MITEVT/opel_power_distribution_monitor/hardware/opel_pdm.kicad_pcb

## KiCad design hardware/opel_pdm.kicad_pcb (2016-10-30)

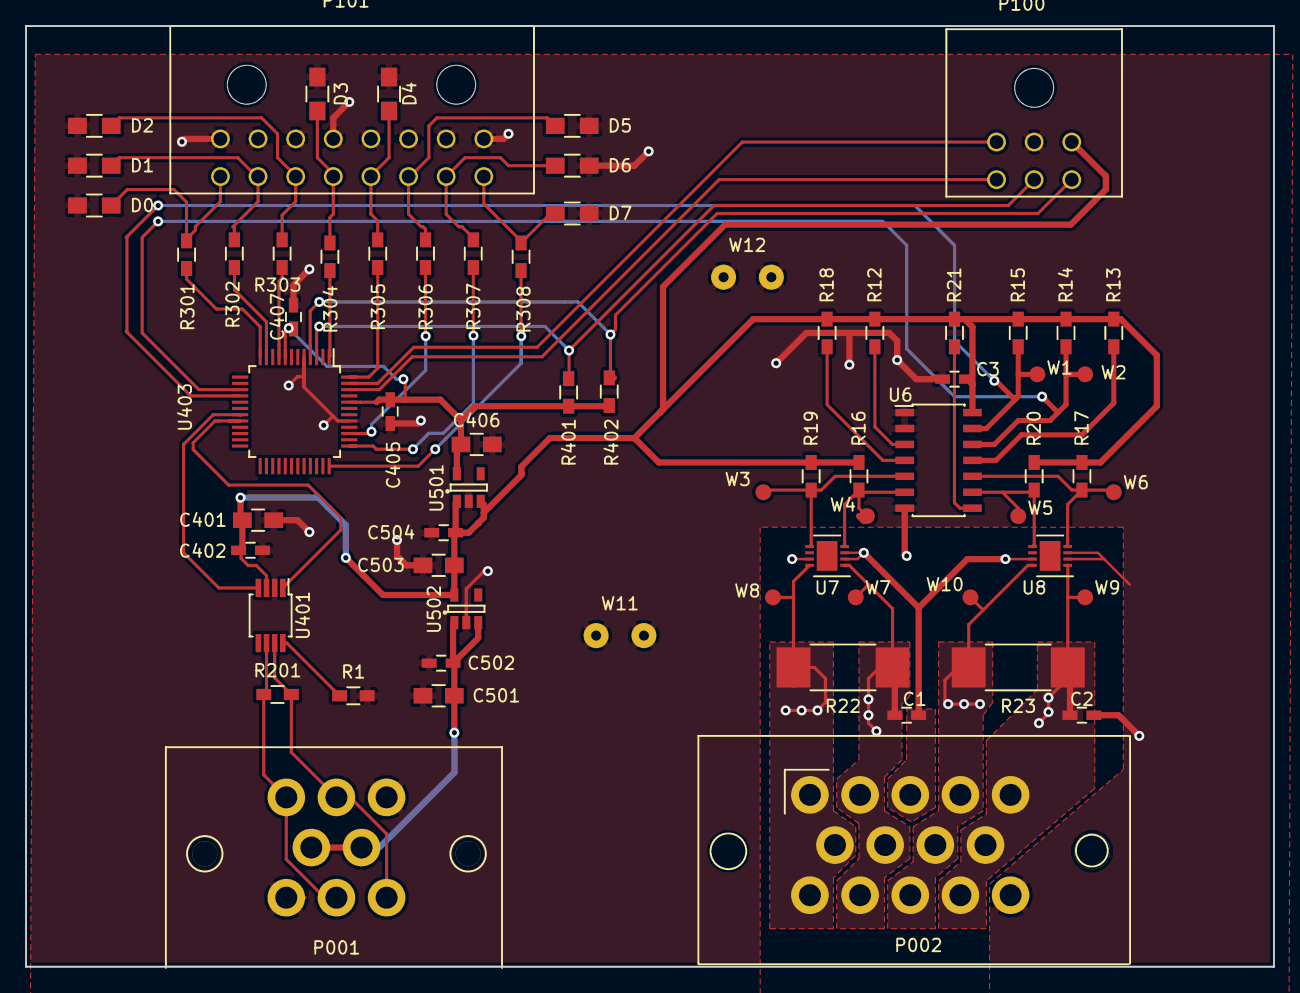
[picture p1: board opel_pdm.kicad_pcb from above]

Board: 2 copper layers, 99.5 x 75.0 mm, 67 parts (0 on the bottom side), 43 nets.

Parts:
C1, C2: 1uF; C_0603_HandSoldering
C3, C402, C405, C407: 0.1uF; C_0603_HandSoldering
C401, C406: 10uF; C_0805_HandSoldering
C501, C503: 10μ; C_0805_HandSoldering
C502, C504: .1μ; C_0603_HandSoldering
D0: PIO2_8; R_0805_HandSoldering
D1: PIO2_7; R_0805_HandSoldering
D2: PIO1_8; R_0805_HandSoldering
D3: PIO2_6; R_0805_HandSoldering
D4: PIO3_3; R_0805_HandSoldering
D5: PIO1_3; R_0805_HandSoldering
D6: PIO3_1; R_0805_HandSoldering
D7: PIO3_0; R_0805_HandSoldering
P001: CANCONNECTOR; 776280-1
P002: CONN_01X14; 776267-1
P100: ISP; Connector_Microfit3_Header_02x03_Angled_43045-060x
P101: DEBUG_LED; Connector_Microfit3_Header_02x08_Angled_43045-160x
R1: 20k; R_0603_HandSoldering
R12, R13, R14, R15, R16, R17, R18, R19, R20, R21, R401, R402: 10k; R_0603_HandSoldering
R22, R23: 0.002; R_2512_HandSoldering
R201: 120; R_0603_HandSoldering
R301, R302, R303, R304, R305, R306, R307, R308: 100; R_0603_HandSoldering
U6: TCA9543A; SOIC-14_3.9x8.7mm_Pitch1.27mm
U7, U8: LTC2943; DFN-8-1EP_3x3mm_Pitch0.5mm
U401: MCP2551-I/SN; MSOP-8_3x3mm_Pitch0.65mm
U403: LPC11C14; LQFP-48_7x7mm_Pitch0.5mm
U501: MCP1755-33; SOT-23-5
U502: MCP1755-5; SOT-23-5
W1: SDA; smd_test_pad
W2: SCL; smd_test_pad
W3: SD0; smd_test_pad
W4: SC0; smd_test_pad
W5, W6: SD1; smd_test_pad
W7: CS+; smd_test_pad
W8: CS-; smd_test_pad
W9: LV+; smd_test_pad
W10: LV-; smd_test_pad
W11, W12: TST_GND; SolderWirePad_2x_0-8mmDrill

Connections:
+3V3: C405.1, C406.1, C407.1, R401.1, R402.1, U403.8, U403.44, U501.5
+5V: C3.1, C401.1, C402.1, C503.1, C504.1, P100.3, R12.1, R13.1, R14.1, R15.1, R16.1, R17.1, R18.1, R19.1, R20.1, R21.1, U6.14, U401.3, U501.1, U501.3, U502.5
/BACK_PANEL/CANH: P001.2, P001.8, R201.2, U401.7
/BACK_PANEL/CANL: P001.1, P001.7, R201.1, U401.6
/BACK_PANEL/CS_SENSE+: C1.1, P002.2, P002.7, P002.11, R22.1, U7.1, W7.1
/BACK_PANEL/CS_SENSE-: P002.1, P002.6, P002.10, R22.2, U7.8, W8.1
/BACK_PANEL/LV_SENSE+: C2.1, P002.5, P002.9, P002.13, R23.1, U8.1, W9.1
/BACK_PANEL/LV_SENSE-: P002.4, P002.8, P002.12, R23.2, U8.8, W10.1
/FRONT_PANEL/LED0: R301.1, U403.12
/FRONT_PANEL/LED1: R302.2, U403.11
/FRONT_PANEL/LED2: R303.2, U403.9
/FRONT_PANEL/LED3: R304.1, U403.1
/FRONT_PANEL/LED4: R305.2, U403.48
/FRONT_PANEL/LED5: R306.1, U403.39
/FRONT_PANEL/LED6: R307.2, U403.37
/FRONT_PANEL/LED7: R308.1, U403.36
/FRONT_PANEL/MCU_PROG_N: P100.6, R402.2, U403.4
/FRONT_PANEL/MCU_RESET_N: P100.5, R401.2, U403.3
/FRONT_PANEL/RXD: P100.4, U403.46
/FRONT_PANEL/TXD: P100.1, U403.47
/I2C Multiplexer and Gas Gauges/SCL: R14.2, U6.12, U403.15, W2.1
/I2C Multiplexer and Gas Gauges/SDA: R15.2, U6.13, U403.16, W1.1
/Micro_Controller/CAN_RXD: U401.4, U403.19
/Micro_Controller/CAN_TXD: U401.1, U403.20
/Power_Supplies/+12V: C501.2, C502.1, P001.4, P001.5, U502.1, U502.3
GND: C1.2, C2.2, C3.2, C401.2, C402.2, C405.2, C406.2, C407.2, C501.1, C502.2, C503.2, C504.2, D0.1, D1.1, D2.1, D3.1, D4.1, D5.1, D6.1, D7.1, P001.3, P001.6, P002.3, P002.14, P100.2, P101.1, P101.2, P101.3, P101.4, P101.5, P101.6, P101.7, P101.8, R1.2, U6.1, U6.2, U6.7, U7.2, U7.3, U7.7, U8.2, U8.3, U8.7, U401.2, U403.5, U403.41, U501.2, U502.2, W11.1, W12.1
unnamed: D0.2, P101.9, R301.2
unnamed: D1.2, P101.10, R302.1
unnamed: D2.2, P101.11, R303.1
unnamed: D3.2, P101.12, R304.2
unnamed: D4.2, P101.13, R305.1
unnamed: D5.2, P101.14, R306.2
unnamed: D6.2, P101.15, R307.1
unnamed: D7.2, P101.16, R308.2
unnamed: R1.1, U401.8
unnamed: R12.2, U6.3
unnamed: R13.2, U6.11
unnamed: R16.2, U6.6, U7.4, W4.1
unnamed: R17.2, U6.10, U8.4, W6.1
unnamed: R18.2, U6.4
unnamed: R19.2, U6.5, U7.5, W3.1
unnamed: R20.2, U6.9, U8.5, W5.1
unnamed: R21.2, U6.8
