MITEVT/opel_power_distribution_monitor/firmware/inc/can_spec_constants.h

#define BMS_HEARTBEAT__id 1536
#define BMS_HEARTBEAT__freq 1
#define __BMS_HEARTBEAT__DEVICE_ID__start 0
#define __BMS_HEARTBEAT__DEVICE_ID__end 31
#define ____BMS_HEARTBEAT__DEVICE_ID__DEVICE_ID__FROM 0
#define ____BMS_HEARTBEAT__DEVICE_ID__DEVICE_ID__TO 4294967295
#define __BMS_HEARTBEAT__SERIAL_NO__start 32
#define __BMS_HEARTBEAT__SERIAL_NO__end 63
#define ____BMS_HEARTBEAT__SERIAL_NO__SERIAL_NO__FROM 0
#define ____BMS_HEARTBEAT__SERIAL_NO__SERIAL_NO__TO 4294967295

#define TI_PACKET__id 769
#define TI_PACKET__freq 100
#define __TI_PACKET__ACC_VAL__start 0
#define __TI_PACKET__ACC_VAL__end 7
#define ____TI_PACKET__ACC_VAL__ACC_VAL__FROM 0
#define ____TI_PACKET__ACC_VAL__ACC_VAL__TO 255
#define __TI_PACKET__BRAKE_VAL__start 8
#define __TI_PACKET__BRAKE_VAL__end 15
#define ____TI_PACKET__BRAKE_VAL__BRAKE_VAL__FROM 0
#define ____TI_PACKET__BRAKE_VAL__BRAKE_VAL__TO 255
#define __TI_PACKET__FLAGS__start 16
#define __TI_PACKET__FLAGS__end 23
#define ____TI_PACKET__FLAGS__FLAGS__FROM 0
#define ____TI_PACKET__FLAGS__FLAGS__TO 255

#define WHEEL_VELOCITY_1__id 1795
#define WHEEL_VELOCITY_1__freq 5
#define __WHEEL_VELOCITY_1__WHEEL_VELOCITY_1__start 0
#define __WHEEL_VELOCITY_1__WHEEL_VELOCITY_1__end 15
#define ____WHEEL_VELOCITY_1__WHEEL_VELOCITY_1__WHEEL_VELOCITY_RPM__FROM 0
#define ____WHEEL_VELOCITY_1__WHEEL_VELOCITY_1__WHEEL_VELOCITY_RPM__TO 65535

#define WHEEL_VELOCITY_2__id 1796
#define WHEEL_VELOCITY_2__freq 5
#define __WHEEL_VELOCITY_2__WHEEL_VELOCITY_2__start 0
#define __WHEEL_VELOCITY_2__WHEEL_VELOCITY_2__end 15
#define ____WHEEL_VELOCITY_2__WHEEL_VELOCITY_2__WHEEL_VELOCITY_RPM__FROM 0
#define ____WHEEL_VELOCITY_2__WHEEL_VELOCITY_2__WHEEL_VELOCITY_RPM__TO 65535

#define MI_PACKET__id 1797
#define MI_PACKET__freq 1
#define __MI_PACKET__IS_SHUTDOWN_OK__start 0
#define __MI_PACKET__IS_SHUTDOWN_OK__end 1
#define ____MI_PACKET__IS_SHUTDOWN_OK__OK 0
#define ____MI_PACKET__IS_SHUTDOWN_OK__NOT_OKAY 1
#define __MI_PACKET__MOTOR_CURRENT__start 2
#define __MI_PACKET__MOTOR_CURRENT__end 17
#define ____MI_PACKET__MOTOR_CURRENT__CURRENT_AMPS__FROM 0
#define ____MI_PACKET__MOTOR_CURRENT__CURRENT_AMPS__TO 65535

#define ERROR_PACKET__id 1286
#define ERROR_PACKET__freq 2
#define __ERROR_PACKET__ERROR__start 0
#define __ERROR_PACKET__ERROR__end 19
#define ____ERROR_PACKET__ERROR__LOST_VELOCITY_HEARTBEAT 0
#define ____ERROR_PACKET__ERROR__LOST_PDM_YHEARTBEAT 240
#define ____ERROR_PACKET__ERROR__LOST_BMS_HEARTBEAT 61440
#define ____ERROR_PACKET__ERROR__LOST_THROTTLE_HEARTBEAT 3840
#define ____ERROR_PACKET__ERROR__ERROR_NONE 983040

#define BRUSA_NLG5_DIAG_RX__id 1816
#define BRUSA_NLG5_DIAG_RX__freq -1

#define BRUSA_NLG5_STATUS__id 1552
#define BRUSA_NLG5_STATUS__freq 10

#define BRUSA_NLG5_ACTUAL_VALUES_1__id 1553
#define BRUSA_NLG5_ACTUAL_VALUES_1__freq 10

#define BRUSA_NLG5_ACTUAL_VALUES_2__id 1554
#define BRUSA_NLG5_ACTUAL_VALUES_2__freq 10

#define BRUSA_NLG5_TEMP_FEEDBACK__id 1555
#define BRUSA_NLG5_TEMP_FEEDBACK__freq 1

#define BRUSA_NLG5_ERRORS__id 1556
#define BRUSA_NLG5_ERRORS__freq 1

#define BRUSA_NLG5_CONTROL__id 1560
#define BRUSA_NLG5_CONTROL__freq 10

#define BRUSA_NLG5_DIAG_TX__id 1818
#define BRUSA_NLG5_DIAG_TX__freq -1

#define PDM_PACKET__id 773
#define PDM_PACKET__freq 10
#define __PDM_PACKET__LOW_VOLTAGE_BUS_BATTERY_FLAG__start 0
#define __PDM_PACKET__LOW_VOLTAGE_BUS_BATTERY_FLAG__end 0
#define ____PDM_PACKET__LOW_VOLTAGE_BUS_BATTERY_FLAG__DOWN 0
#define ____PDM_PACKET__LOW_VOLTAGE_BUS_BATTERY_FLAG__UP 1
#define __PDM_PACKET__LOW_VOLTAGE_DC_DC_STATUS__start 1
#define __PDM_PACKET__LOW_VOLTAGE_DC_DC_STATUS__end 1
#define ____PDM_PACKET__LOW_VOLTAGE_DC_DC_STATUS__OFF 0
#define ____PDM_PACKET__LOW_VOLTAGE_DC_DC_STATUS__ON 1
#define __PDM_PACKET__CRITICAL_SYSTEMS_BATTERY_FLAG__start 2
#define __PDM_PACKET__CRITICAL_SYSTEMS_BATTERY_FLAG__end 2
#define ____PDM_PACKET__CRITICAL_SYSTEMS_BATTERY_FLAG__DOWN 0
#define ____PDM_PACKET__CRITICAL_SYSTEMS_BATTERY_FLAG__UP 1
#define __PDM_PACKET__CRITICAL_SYSTEMS_DC_DC_STATUS__start 3
#define __PDM_PACKET__CRITICAL_SYSTEMS_DC_DC_STATUS__end 3
#define ____PDM_PACKET__CRITICAL_SYSTEMS_DC_DC_STATUS__OFF 0
#define ____PDM_PACKET__CRITICAL_SYSTEMS_DC_DC_STATUS__ON 1
#define __PDM_PACKET__PDM_STATUS__start 4
#define __PDM_PACKET__PDM_STATUS__end 4
#define ____PDM_PACKET__PDM_STATUS__OFF 0
#define ____PDM_PACKET__PDM_STATUS__ON 1

#define TRITIUM_BOOTLOADER_RESERVED4__id 2036
#define TRITIUM_BOOTLOADER_RESERVED4__freq -1

#define UI_PACKET__id 2037
#define UI_PACKET__freq 1
#define __UI_PACKET__UI_HEARTBEAT__start 0
#define __UI_PACKET__UI_HEARTBEAT__end 0
#define ____UI_PACKET__UI_HEARTBEAT__RUNNING 1

#define DI_PACKET__id 1285
#define DI_PACKET__freq 10
#define __DI_PACKET__KEY_IGNITION__start 0
#define __DI_PACKET__KEY_IGNITION__end 15
#define ____DI_PACKET__KEY_IGNITION__RUN 32
#define ____DI_PACKET__KEY_IGNITION__START 64
#define __DI_PACKET__DRIVE_STATUS__start 16
#define __DI_PACKET__DRIVE_STATUS__end 31
#define ____DI_PACKET__DRIVE_STATUS__PARKED 0
#define ____DI_PACKET__DRIVE_STATUS__CHARGE 61440
#define ____DI_PACKET__DRIVE_STATUS__OFF 12288
#define ____DI_PACKET__DRIVE_STATUS__REVERSE 48
#define ____DI_PACKET__DRIVE_STATUS__FORWARD 240
#define ____DI_PACKET__DRIVE_STATUS__SHUTDOWN_IMPENDING 3840
#define ____DI_PACKET__DRIVE_STATUS__INIT 768

#define TRITIUM_BOOTLOADER_RESERVED0__id 2032
#define TRITIUM_BOOTLOADER_RESERVED0__freq -1

#define TRITIUM_BOOTLOADER_RESERVED1__id 2033
#define TRITIUM_BOOTLOADER_RESERVED1__freq -1

#define TRITIUM_BOOTLOADER_RESERVED2__id 2034
#define TRITIUM_BOOTLOADER_RESERVED2__freq -1

#define TRITIUM_BOOTLOADER_RESERVED3__id 2035
#define TRITIUM_BOOTLOADER_RESERVED3__freq -1

#define PACK_CHARGE__id 1780
#define PACK_CHARGE__freq 1
#define __PACK_CHARGE__CHARGE_AH__start 0
#define __PACK_CHARGE__CHARGE_AH__end 31
#define ____PACK_CHARGE__CHARGE_AH__CHARGE_Ah 0
#define __PACK_CHARGE__CHARGE_PERCENTAGE__start 32
#define __PACK_CHARGE__CHARGE_PERCENTAGE__end 63
#define ____PACK_CHARGE__CHARGE_PERCENTAGE__CHARGE_PERCENTAGE 0

#define PACK_CHARGE_MISBALANCE__id 1781
#define PACK_CHARGE_MISBALANCE__freq 1
#define __PACK_CHARGE_MISBALANCE__BALANCE_SOC__start 0
#define __PACK_CHARGE_MISBALANCE__BALANCE_SOC__end 31
#define ____PACK_CHARGE_MISBALANCE__BALANCE_SOC__MISMATCH_CORRECTED_BALANCE_MISMATCH_Ah 0
#define __PACK_CHARGE_MISBALANCE__PACK_BALANCE_SOC__start 32
#define __PACK_CHARGE_MISBALANCE__PACK_BALANCE_SOC__end 63
#define ____PACK_CHARGE_MISBALANCE__PACK_BALANCE_SOC__CHARGE_PERCENTAGE_MISMATCH 0

#define CHARGING_CONTROL_INFO__id 1782
#define CHARGING_CONTROL_INFO__freq 10
#define __CHARGING_CONTROL_INFO__CHARGING_CELL_VOLTAGE_ERROR__start 0
#define __CHARGING_CONTROL_INFO__CHARGING_CELL_VOLTAGE_ERROR__end 15
#define ____CHARGING_CONTROL_INFO__CHARGING_CELL_VOLTAGE_ERROR__ERROR_mV__FROM 0
#define ____CHARGING_CONTROL_INFO__CHARGING_CELL_VOLTAGE_ERROR__ERROR_mV__TO 65535
#define __CHARGING_CONTROL_INFO__CELL_TEMP_MARGIN__start 16
#define __CHARGING_CONTROL_INFO__CELL_TEMP_MARGIN__end 31
#define ____CHARGING_CONTROL_INFO__CELL_TEMP_MARGIN__CELL_TEMP_TENTH_C__FROM 0
#define ____CHARGING_CONTROL_INFO__CELL_TEMP_MARGIN__CELL_TEMP_TENTH_C__TO 65535
#define __CHARGING_CONTROL_INFO__DISCHARGING_CELL_VOLTAGE_ERROR__start 32
#define __CHARGING_CONTROL_INFO__DISCHARGING_CELL_VOLTAGE_ERROR__end 47
#define ____CHARGING_CONTROL_INFO__DISCHARGING_CELL_VOLTAGE_ERROR__ERROR_mV__FROM 0
#define ____CHARGING_CONTROL_INFO__DISCHARGING_CELL_VOLTAGE_ERROR__ERROR_mV__TO 65535
#define __CHARGING_CONTROL_INFO__TOTAL_PACK_CAPACITY__start 48
#define __CHARGING_CONTROL_INFO__TOTAL_PACK_CAPACITY__end 63
#define ____CHARGING_CONTROL_INFO__TOTAL_PACK_CAPACITY__CAPACITY_Ah__FROM 0
#define ____CHARGING_CONTROL_INFO__TOTAL_PACK_CAPACITY__CAPACITY_Ah__TO 65535

#define PRECHARGE_STATUS__id 1783
#define PRECHARGE_STATUS__freq 1
#define __PRECHARGE_STATUS__CONTACTOR_1_ERROR__start 0
#define __PRECHARGE_STATUS__CONTACTOR_1_ERROR__end 0
#define ____PRECHARGE_STATUS__CONTACTOR_1_ERROR__OK 0
#define ____PRECHARGE_STATUS__CONTACTOR_1_ERROR__FAULT 1
#define __PRECHARGE_STATUS__CONTACTOR_2_ERROR__start 1
#define __PRECHARGE_STATUS__CONTACTOR_2_ERROR__end 1
#define ____PRECHARGE_STATUS__CONTACTOR_2_ERROR__OK 0
#define ____PRECHARGE_STATUS__CONTACTOR_2_ERROR__FAULT 1
#define __PRECHARGE_STATUS__CONTACTOR_1_STATUS__start 2
#define __PRECHARGE_STATUS__CONTACTOR_1_STATUS__end 2
#define ____PRECHARGE_STATUS__CONTACTOR_1_STATUS__OFF 0
#define ____PRECHARGE_STATUS__CONTACTOR_1_STATUS__ON 1
#define __PRECHARGE_STATUS__CONTACTOR_2_STATUS__start 3
#define __PRECHARGE_STATUS__CONTACTOR_2_STATUS__end 3
#define ____PRECHARGE_STATUS__CONTACTOR_2_STATUS__OFF 0
#define ____PRECHARGE_STATUS__CONTACTOR_2_STATUS__ON 1
#define __PRECHARGE_STATUS__12V_CONTACTOR_STATUS__start 4
#define __PRECHARGE_STATUS__12V_CONTACTOR_STATUS__end 4
#define ____PRECHARGE_STATUS__12V_CONTACTOR_STATUS__FAULT 0
#define ____PRECHARGE_STATUS__12V_CONTACTOR_STATUS__OK 1
#define __PRECHARGE_STATUS__CONTACTOR_3_ERROR__start 5
#define __PRECHARGE_STATUS__CONTACTOR_3_ERROR__end 5
#define ____PRECHARGE_STATUS__CONTACTOR_3_ERROR__OK 0
#define ____PRECHARGE_STATUS__CONTACTOR_3_ERROR__FAULT 1
#define __PRECHARGE_STATUS__CONTACTOR_3_STATUS__start 6
#define __PRECHARGE_STATUS__CONTACTOR_3_STATUS__end 6
#define ____PRECHARGE_STATUS__CONTACTOR_3_STATUS__OFF 0
#define ____PRECHARGE_STATUS__CONTACTOR_3_STATUS__ON 1
#define __PRECHARGE_STATUS__PRECHARGE_STATE__start 7
#define __PRECHARGE_STATUS__PRECHARGE_STATE__end 7

#define CELL_VOLTAGES__id 1784
#define CELL_VOLTAGES__freq 10
#define __CELL_VOLTAGES__MIN_CELL_VOLTAGE__start 0
#define __CELL_VOLTAGES__MIN_CELL_VOLTAGE__end 15
#define ____CELL_VOLTAGES__MIN_CELL_VOLTAGE__VOLTAGE_mV__FROM 0
#define ____CELL_VOLTAGES__MIN_CELL_VOLTAGE__VOLTAGE_mV__TO 65535
#define __CELL_VOLTAGES__MAX_CELL_VOLTAGE__start 16
#define __CELL_VOLTAGES__MAX_CELL_VOLTAGE__end 31
#define ____CELL_VOLTAGES__MAX_CELL_VOLTAGE__VOLTAGE_mV__FROM 0
#define ____CELL_VOLTAGES__MAX_CELL_VOLTAGE__VOLTAGE_mV__TO 65535
#define __CELL_VOLTAGES__CMU_WITH_MIN_VOLTAGE__start 32
#define __CELL_VOLTAGES__CMU_WITH_MIN_VOLTAGE__end 39
#define ____CELL_VOLTAGES__CMU_WITH_MIN_VOLTAGE__CMU_NO__FROM 0
#define ____CELL_VOLTAGES__CMU_WITH_MIN_VOLTAGE__CMU_NO__TO 255
#define __CELL_VOLTAGES__CELL_WITH_MIN_VOLTAGE__start 40
#define __CELL_VOLTAGES__CELL_WITH_MIN_VOLTAGE__end 47
#define ____CELL_VOLTAGES__CELL_WITH_MIN_VOLTAGE__CELL_NO__FROM 0
#define ____CELL_VOLTAGES__CELL_WITH_MIN_VOLTAGE__CELL_NO__TO 255
#define __CELL_VOLTAGES__CMU_WITH_MAX_VOLTAGE__start 48
#define __CELL_VOLTAGES__CMU_WITH_MAX_VOLTAGE__end 55
#define ____CELL_VOLTAGES__CMU_WITH_MAX_VOLTAGE__CMU_NO__FROM 0
#define ____CELL_VOLTAGES__CMU_WITH_MAX_VOLTAGE__CMU_NO__TO 255
#define __CELL_VOLTAGES__CELL_WITH_MAX_VOLTAGE__start 56
#define __CELL_VOLTAGES__CELL_WITH_MAX_VOLTAGE__end 63
#define ____CELL_VOLTAGES__CELL_WITH_MAX_VOLTAGE__CELL_NO__FROM 0
#define ____CELL_VOLTAGES__CELL_WITH_MAX_VOLTAGE__CELL_NO__TO 255

#define CELL_TEMPS__id 1785
#define CELL_TEMPS__freq 1
#define __CELL_TEMPS__MIN_CELL_TEMP__start 0
#define __CELL_TEMPS__MIN_CELL_TEMP__end 15
#define ____CELL_TEMPS__MIN_CELL_TEMP__TEMP_TENTHS_C__FROM 0
#define ____CELL_TEMPS__MIN_CELL_TEMP__TEMP_TENTHS_C__TO 65535
#define __CELL_TEMPS__MAX_CELL_TEMP__start 16
#define __CELL_TEMPS__MAX_CELL_TEMP__end 31
#define ____CELL_TEMPS__MAX_CELL_TEMP__TEMP_TENTHS_C__FROM 0
#define ____CELL_TEMPS__MAX_CELL_TEMP__TEMP_TENTHS_C__TO 65535
#define __CELL_TEMPS__CMU_WITH_MIN_TEMP__start 32
#define __CELL_TEMPS__CMU_WITH_MIN_TEMP__end 39
#define ____CELL_TEMPS__CMU_WITH_MIN_TEMP__CMU_NO__FROM 0
#define ____CELL_TEMPS__CMU_WITH_MIN_TEMP__CMU_NO__TO 255
#define __CELL_TEMPS__CMU_WITH_MAX_TEMP__start 48
#define __CELL_TEMPS__CMU_WITH_MAX_TEMP__end 55
#define ____CELL_TEMPS__CMU_WITH_MAX_TEMP__CMU_NO__FROM 0
#define ____CELL_TEMPS__CMU_WITH_MAX_TEMP__CMU_NO__TO 255

#define BATTERY_CURRENT_VOLTAGE__id 1786
#define BATTERY_CURRENT_VOLTAGE__freq 10
#define __BATTERY_CURRENT_VOLTAGE__VOLTAGE__start 0
#define __BATTERY_CURRENT_VOLTAGE__VOLTAGE__end 31
#define ____BATTERY_CURRENT_VOLTAGE__VOLTAGE__VOLTAGE_mV__FROM 0
#define ____BATTERY_CURRENT_VOLTAGE__VOLTAGE__VOLTAGE_mV__TO 4294967295
#define __BATTERY_CURRENT_VOLTAGE__CURRENT__start 32
#define __BATTERY_CURRENT_VOLTAGE__CURRENT__end 63
#define ____BATTERY_CURRENT_VOLTAGE__CURRENT__CURRENT_mA__FROM 0
#define ____BATTERY_CURRENT_VOLTAGE__CURRENT__CURRENT_mA__TO 4294967295

#define OVERALL_PACK_STATUS__id 1787
#define OVERALL_PACK_STATUS__freq 0
#define __OVERALL_PACK_STATUS__BALANCE_VOLTAGE_THRESHOLD_RISING__start 0
#define __OVERALL_PACK_STATUS__BALANCE_VOLTAGE_THRESHOLD_RISING__end 15
#define ____OVERALL_PACK_STATUS__BALANCE_VOLTAGE_THRESHOLD_RISING__THRESHOLD__FROM 0
#define ____OVERALL_PACK_STATUS__BALANCE_VOLTAGE_THRESHOLD_RISING__THRESHOLD__TO 65535
#define __OVERALL_PACK_STATUS__BALANCE_VOLTAGE_THRESHOLD_FALLING__start 16
#define __OVERALL_PACK_STATUS__BALANCE_VOLTAGE_THRESHOLD_FALLING__end 31
#define ____OVERALL_PACK_STATUS__BALANCE_VOLTAGE_THRESHOLD_FALLING__THRESHOLD__FROM 0
#define ____OVERALL_PACK_STATUS__BALANCE_VOLTAGE_THRESHOLD_FALLING__THRESHOLD__TO 65535
#define __OVERALL_PACK_STATUS__CELL_OVER_VOLTAGE__start 32
#define __OVERALL_PACK_STATUS__CELL_OVER_VOLTAGE__end 32
#define ____OVERALL_PACK_STATUS__CELL_OVER_VOLTAGE__FALSE 0
#define ____OVERALL_PACK_STATUS__CELL_OVER_VOLTAGE__TRUE 1
#define __OVERALL_PACK_STATUS__CELL_UNDER_VOLTAGE__start 33
#define __OVERALL_PACK_STATUS__CELL_UNDER_VOLTAGE__end 33
#define ____OVERALL_PACK_STATUS__CELL_UNDER_VOLTAGE__FALSE 0
#define ____OVERALL_PACK_STATUS__CELL_UNDER_VOLTAGE__TRUE 1
#define __OVERALL_PACK_STATUS__CELL_OVER_TEMPERATURE__start 34
#define __OVERALL_PACK_STATUS__CELL_OVER_TEMPERATURE__end 34
#define ____OVERALL_PACK_STATUS__CELL_OVER_TEMPERATURE__FALSE 0
#define ____OVERALL_PACK_STATUS__CELL_OVER_TEMPERATURE__TRUE 1
#define __OVERALL_PACK_STATUS__MEASUREMENTS_UNTRUSTED__start 35
#define __OVERALL_PACK_STATUS__MEASUREMENTS_UNTRUSTED__end 35
#define ____OVERALL_PACK_STATUS__MEASUREMENTS_UNTRUSTED__FALSE 0
#define ____OVERALL_PACK_STATUS__MEASUREMENTS_UNTRUSTED__TRUE 1
#define __OVERALL_PACK_STATUS__CMU_COMMUNICATION_TIMEOUT__start 36
#define __OVERALL_PACK_STATUS__CMU_COMMUNICATION_TIMEOUT__end 36
#define ____OVERALL_PACK_STATUS__CMU_COMMUNICATION_TIMEOUT__FALSE 0
#define ____OVERALL_PACK_STATUS__CMU_COMMUNICATION_TIMEOUT__TRUE 1
#define __OVERALL_PACK_STATUS__VEHICLE_COMMUNICATIONS_TIMOUT__start 37
#define __OVERALL_PACK_STATUS__VEHICLE_COMMUNICATIONS_TIMOUT__end 37
#define ____OVERALL_PACK_STATUS__VEHICLE_COMMUNICATIONS_TIMOUT__FALSE 0
#define ____OVERALL_PACK_STATUS__VEHICLE_COMMUNICATIONS_TIMOUT__TRUE 1
#define __OVERALL_PACK_STATUS__BMS_SETUP_MODE__start 38
#define __OVERALL_PACK_STATUS__BMS_SETUP_MODE__end 38
#define ____OVERALL_PACK_STATUS__BMS_SETUP_MODE__OFF 0
#define ____OVERALL_PACK_STATUS__BMS_SETUP_MODE__ON 1
#define __OVERALL_PACK_STATUS__CMU_CAN_POWER_STATUS__start 39
#define __OVERALL_PACK_STATUS__CMU_CAN_POWER_STATUS__end 39
#define ____OVERALL_PACK_STATUS__CMU_CAN_POWER_STATUS__OFF 0
#define ____OVERALL_PACK_STATUS__CMU_CAN_POWER_STATUS__ON 1
#define __OVERALL_PACK_STATUS__CMU_COUNT__start 40
#define __OVERALL_PACK_STATUS__CMU_COUNT__end 47
#define ____OVERALL_PACK_STATUS__CMU_COUNT__COUNT__FROM 0
#define ____OVERALL_PACK_STATUS__CMU_COUNT__COUNT__TO 255
#define __OVERALL_PACK_STATUS__FIRMWARE_BUILD_NO__start 48
#define __OVERALL_PACK_STATUS__FIRMWARE_BUILD_NO__end 63
#define ____OVERALL_PACK_STATUS__FIRMWARE_BUILD_NO__VERSION__FROM 0
#define ____OVERALL_PACK_STATUS__FIRMWARE_BUILD_NO__VERSION__TO 65535

#define FAN_INFO__id 1788
#define FAN_INFO__freq 0
#define __FAN_INFO__FAN0_STATUS__start 0
#define __FAN_INFO__FAN0_STATUS__end 15
#define ____FAN_INFO__FAN0_STATUS__SPEED_RPM__FROM 0
#define ____FAN_INFO__FAN0_STATUS__SPEED_RPM__TO 65535
#define __FAN_INFO__FAN1_STATUS__start 16
#define __FAN_INFO__FAN1_STATUS__end 31
#define ____FAN_INFO__FAN1_STATUS__SPEED_RPM__FROM 0
#define ____FAN_INFO__FAN1_STATUS__SPEED_RPM__TO 65535
#define __FAN_INFO__FAN_AND_CONTACTOR_12V_CURRENT_CONSUMPTION__start 32
#define __FAN_INFO__FAN_AND_CONTACTOR_12V_CURRENT_CONSUMPTION__end 47
#define ____FAN_INFO__FAN_AND_CONTACTOR_12V_CURRENT_CONSUMPTION__CONSUMPTION_mA__FROM 0
#define ____FAN_INFO__FAN_AND_CONTACTOR_12V_CURRENT_CONSUMPTION__CONSUMPTION_mA__TO 65535
#define __FAN_INFO__CMU_12V_CURRENT_CONSUMPTION__start 48
#define __FAN_INFO__CMU_12V_CURRENT_CONSUMPTION__end 63
#define ____FAN_INFO__CMU_12V_CURRENT_CONSUMPTION__CONSUMPTION_mA__FROM 0
#define ____FAN_INFO__CMU_12V_CURRENT_CONSUMPTION__CONSUMPTION_mA__TO 65535

#define EXTENDED_PACK_STATUS__id 1789
#define EXTENDED_PACK_STATUS__freq 0
#define __EXTENDED_PACK_STATUS__CELL_OVER_VOLTAGE__start 0
#define __EXTENDED_PACK_STATUS__CELL_OVER_VOLTAGE__end 0
#define ____EXTENDED_PACK_STATUS__CELL_OVER_VOLTAGE__FALSE 0
#define ____EXTENDED_PACK_STATUS__CELL_OVER_VOLTAGE__TRUE 1
#define __EXTENDED_PACK_STATUS__CELL_UNDER_VOLTAGE__start 1
#define __EXTENDED_PACK_STATUS__CELL_UNDER_VOLTAGE__end 1
#define ____EXTENDED_PACK_STATUS__CELL_UNDER_VOLTAGE__FALSE 0
#define ____EXTENDED_PACK_STATUS__CELL_UNDER_VOLTAGE__TRUE 1
#define __EXTENDED_PACK_STATUS__CELL_OVER_TEMPERATURE__start 2
#define __EXTENDED_PACK_STATUS__CELL_OVER_TEMPERATURE__end 2
#define ____EXTENDED_PACK_STATUS__CELL_OVER_TEMPERATURE__FALSE 0
#define ____EXTENDED_PACK_STATUS__CELL_OVER_TEMPERATURE__TRUE 1
#define __EXTENDED_PACK_STATUS__MEASUREMENTS_UNTRUSTED__start 3
#define __EXTENDED_PACK_STATUS__MEASUREMENTS_UNTRUSTED__end 3
#define ____EXTENDED_PACK_STATUS__MEASUREMENTS_UNTRUSTED__FALSE 0
#define ____EXTENDED_PACK_STATUS__MEASUREMENTS_UNTRUSTED__TRUE 1
#define __EXTENDED_PACK_STATUS__LOST_CMU_COMMUNICATION__start 4
#define __EXTENDED_PACK_STATUS__LOST_CMU_COMMUNICATION__end 4
#define ____EXTENDED_PACK_STATUS__LOST_CMU_COMMUNICATION__FALSE 0
#define ____EXTENDED_PACK_STATUS__LOST_CMU_COMMUNICATION__TRUE 1
#define __EXTENDED_PACK_STATUS__VEHICLE_COMMUNICATIONS_TIMOUT__start 5
#define __EXTENDED_PACK_STATUS__VEHICLE_COMMUNICATIONS_TIMOUT__end 5
#define ____EXTENDED_PACK_STATUS__VEHICLE_COMMUNICATIONS_TIMOUT__FALSE 0
#define ____EXTENDED_PACK_STATUS__VEHICLE_COMMUNICATIONS_TIMOUT__TRUE 1
#define __EXTENDED_PACK_STATUS__BMS_SETUP_MODE__start 6
#define __EXTENDED_PACK_STATUS__BMS_SETUP_MODE__end 6
#define ____EXTENDED_PACK_STATUS__BMS_SETUP_MODE__OFF 0
#define ____EXTENDED_PACK_STATUS__BMS_SETUP_MODE__ON 1
#define __EXTENDED_PACK_STATUS__CMU_CAN_POWER_STATUS__start 7
#define __EXTENDED_PACK_STATUS__CMU_CAN_POWER_STATUS__end 7
#define ____EXTENDED_PACK_STATUS__CMU_CAN_POWER_STATUS__OFF 0
#define ____EXTENDED_PACK_STATUS__CMU_CAN_POWER_STATUS__ON 1
#define __EXTENDED_PACK_STATUS__PACK_ISOLATION_TEST_FAILURE__start 8
#define __EXTENDED_PACK_STATUS__PACK_ISOLATION_TEST_FAILURE__end 8
#define ____EXTENDED_PACK_STATUS__PACK_ISOLATION_TEST_FAILURE__FALSE 0
#define ____EXTENDED_PACK_STATUS__PACK_ISOLATION_TEST_FAILURE__TRUE 1
#define __EXTENDED_PACK_STATUS__INVALID_SOC_MEASUREMENT__start 9
#define __EXTENDED_PACK_STATUS__INVALID_SOC_MEASUREMENT__end 9
#define ____EXTENDED_PACK_STATUS__INVALID_SOC_MEASUREMENT__FALSE 0
#define ____EXTENDED_PACK_STATUS__INVALID_SOC_MEASUREMENT__TRUE 1
#define __EXTENDED_PACK_STATUS__CAN_12V_SUPPLY_LOW__start 10
#define __EXTENDED_PACK_STATUS__CAN_12V_SUPPLY_LOW__end 10
#define ____EXTENDED_PACK_STATUS__CAN_12V_SUPPLY_LOW__FALSE 0
#define ____EXTENDED_PACK_STATUS__CAN_12V_SUPPLY_LOW__TRUE 1
#define __EXTENDED_PACK_STATUS__CONTACTOR_STUCK__start 11
#define __EXTENDED_PACK_STATUS__CONTACTOR_STUCK__end 11
#define ____EXTENDED_PACK_STATUS__CONTACTOR_STUCK__FALSE 0
#define ____EXTENDED_PACK_STATUS__CONTACTOR_STUCK__TRUE 1
#define __EXTENDED_PACK_STATUS__CMU_HAS_EXTRA_CELL__start 12
#define __EXTENDED_PACK_STATUS__CMU_HAS_EXTRA_CELL__end 12
#define ____EXTENDED_PACK_STATUS__CMU_HAS_EXTRA_CELL__FALSE 0
#define ____EXTENDED_PACK_STATUS__CMU_HAS_EXTRA_CELL__TRUE 1
#define __EXTENDED_PACK_STATUS__BMU_HARDWARE_VERSION__start 32
#define __EXTENDED_PACK_STATUS__BMU_HARDWARE_VERSION__end 39
#define ____EXTENDED_PACK_STATUS__BMU_HARDWARE_VERSION__NO__FROM 0
#define ____EXTENDED_PACK_STATUS__BMU_HARDWARE_VERSION__NO__TO 255
#define __EXTENDED_PACK_STATUS__BMU_HARDWARE_MODEL__start 40
#define __EXTENDED_PACK_STATUS__BMU_HARDWARE_MODEL__end 47
#define ____EXTENDED_PACK_STATUS__BMU_HARDWARE_MODEL__NO__FROM 0
#define ____EXTENDED_PACK_STATUS__BMU_HARDWARE_MODEL__NO__TO 255

#define TRITIUM_UNUSED_RESERVED0__id 1790
#define TRITIUM_UNUSED_RESERVED0__freq -1

#define TRITIUM_UNUSED_RESERVED1__id 1791
#define TRITIUM_UNUSED_RESERVED1__freq -1
