MITEVT/opel_power_distribution_monitor/(commit log)

2015-11-14 Created basic PDM logic with switches. Fuck you.
2015-11-14 Fixed board.c and board.h. Moved around locations of Pin initialization. Fuck you.
    [board.c, board.h]
2015-11-21 Now sends CAN messages instead of UART.
2016-01-16 Added I2C initialization and read/write functionality. Currently broken.
    [board.c, board.h, main.c]
2016-01-27 Implemented working I2C code to read data from gas gauge.
2016-01-29 Implemented I2C to successfully measure battery current and state of charge.
2016-02-06 Added I2C multiplexer code.
    Implemented I2C channel switching with two channels.
    Updated CAN messaging logic.
    Added pdm shutdown logic.
2016-02-10 Cleaned up code, fixed PDM shutdown logic.
    [board.c, main.c]
2016-02-13 Added PCB design elements.
    Implemented LED debugging.
    Added Kicad schematic for PDM.
    Laid out schematic for I2C multiplexer and two gas gauges.
    [back_panel.sch, final_outline.kicad_pcb, final_outline.sch, front_panel.sch, i2c.sch, mcu.sch, power.sch]
2016-02-26 Fixed renaming issue in schematic, laid out components in pcb.
    [back_panel.sch, final_outline.kicad_pcb, final_outline.sch, front_panel.sch, i2c.sch, mcu.sch, power.sch]
2016-02-27 Finished laying out PCB and completed traces.
    [final_outline.kicad_pcb]
2016-02-27 Finished PCB layout for real this time.
    [final_outline.kicad_pcb]
2016-02-27 Fixed shutdown logic and LED issues.
    [board.h, main.c]
2016-03-12 Fixed connector spacing.
    [final_outline.kicad_pcb]
2016-04-02 Changed gas gauges to reset upon power disconnection. Cleaned up code.
    [board.c, board.h, main.c]
2016-04-16 Fixed multiple PCB issues.
    Fixed track widths.
    Added decoupling capacitor for multiplexer.
    Added additional vias to ground plane.
    Replaced traces with zones for high current connector inputs.
    Added additional input for sense input and ground input to connector.
    Removed 10V voltage regualator and associated circuitry.
    [back_panel.sch, final_outline.kicad_pcb, final_outline.sch, front_panel.sch, i2c.sch, mcu.sch, power.sch]
2016-04-16 Deleted track fragments.
2016-04-16 Fixed connector zone spacing, added vias to back plate.
    [final_outline.kicad_pcb]
2016-04-23 Cleaned up PCB, changed via/zone spacings.
    [final_outline.kicad_pcb]
2016-04-23 Added I2C and CAN header files.
2016-04-23 Renamed i2c header file.
2016-04-30 Renamed PDM hardware files.
    [opel_pdm.kicad_pcb, opel_pdm.sch]
2016-10-22 Added LEDs and another decoupling capacitor to board.
    [back_panel.sch, front_panel.sch, i2c.sch, mcu.sch, opel_pdm.kicad_pcb, opel_pdm.sch, power.sch]
2016-10-29 Added test points, LEDs, 3D model to board.
    [back_panel.sch, front_panel.sch, i2c.sch, mcu.sch, opel_pdm.kicad_pcb, opel_pdm.sch, power.sch]
